JKsuper/Wrench-Racing/README.md

# Wrench Racing — AERO120 LC8

Open `AERO120_R413_ARCHITECTURE/START_HERE_换机接续.md` first, followed by its AGENTS.md and README.md.

Engineering baseline R4.13-LC8. Includes parameterized CadQuery sources, STEP/STL, assembly previews, BOM, geometric checks, manufacturing review and historical archives. Physical load, creep, sealing and aerodynamic validation remain outstanding.

Windows setup scripts are included. Cloud/Linux environments must install CadQuery 2.8.0 and the supplied requirements and verify font availability before rebuilding; Windows Arial Bold geometry must not be silently substituted.

Preserve exact file bytes: CLOUD_FILE_MANIFEST.json records SHA256 checksums. Build the current sources, not archived revisions.
