JKsuper/Wrench-Racing/AERO120_R413_ARCHITECTURE/START_HERE_换机接续.md

# AERO120 LC8 换机接续说明

当前基线 R4.13-LC8，2026-10-30。不要从旧 LC7 重建或混用旧 STL。
原工程目录 C:\Users\nanwa\Downloads\AERO120_R413\AERO120_R413_ARCHITECTURE。
对话属于“王越的项目”，当前任务 ID 01a187e0-4550-7770-b169-2c33f18580b5。
文件包不会自动迁移本地 Codex 对话；优先在同账号打开原对话。若原任务不可见，新对话读取本文件、AGENTS.md、README.md 即可恢复工程上下文。

## 新电脑操作
将整个目录复制/解压到本机可写位置，再在 Codex 中授权该文件夹。
Windows x64 推荐 Python 3.12（原环境3.12.14），CadQuery2.8.0，依赖见03_Codex/simple_lc2/requirements.txt。
先运行 setup_environment.ps1，再运行 run_local.ps1；也可由 Codex 按脚本逐项执行。
不要复用旧机器 AERO120_RUNTIME 环境变量；默认使用项目本地 .venv。不要在两台电脑同时修改同一工作副本。
Wrench Racing 使用 Windows Arial Bold，其他平台或字体不同可能改变字形，必须复核。
当前依赖安装流程尚未在第二台电脑实际运行；必须安装后执行完整构建、测试与导出核验，不承诺未经验证的环境零故障。

## 用户已确认的设计约束
- 单侧目标100元以内，不含风扇，尚无店铺报价。节省打印材料和构件数量，A主风道保持一体，不拆壳。
- 120×120×38–40mm风扇嵌入，腔体121.6mm/轴向43mm；105mm孔距仅参考。KF2510四针出线孔18×14/R2，软片封口。
- A一体风道、B双百叶、C打印底盖及四向支架、D带品牌的可换色前出口装饰盖，共4件。支架不夹在风扇/风道法兰之间。
- 用户现有非沉头M4×16与普通M4螺母；百叶及壳体连接按0.5mm薄平垫、3.5mm螺母包络计算。不是M3。
- 型材连接Ø7通孔配M4/M5/M6螺栓及对应T型槽螺母，用大平垫、每次选两孔；长度按实际T槽确定，不能默认全部16mm。
- 保留4040型材、左右镜像、四角加宽与耳根加强、STRIKE风口、品牌Wrench Racing不反写；D左右通用。
- LC7百叶正面装入曾干涉。LC8将中央造型脊及端桥移到可拆D，先装B再装D，不得恢复A上的固定中央桥。

## 已验证及待办
原目录30项几何回归通过，4份STL独立验证闭合/单连通且与STEP一致。右侧交店包位于12_Prototype_Review/PRINT_SHOP_RIGHT_LC8。
理论PETG净重约298g，不含支撑、损耗及切片变化。可选配合试片约6.5g，不是产品或强度试样。
尚未切片，A内部约110.4×64mm顶面需打印店确认支撑方向及清理方式。用户交打印店，未指定打印机。
后向线束弯曲、前向立柱避让、螺钉/垫圈实配、PETG承载/蠕变/振动/密封/气动需实物验证；几何通过不等于承载或性能通过。
下一步从当前LC8完整文件与交店要求继续，先检查最新校验清单，不重新设计一套。
