JKsuper/Wrench-Racing/AERO120_R413_ARCHITECTURE/12_Prototype_Review/00_打样结论.md

# 2026-10-30 打样审查结论

LC7不直接放行：正面装入百叶与固定中脊存在干涉，原记录00_LC7_assembly_issue_before_fix.json可复查。已修为LC8：中脊移到可拆D，主风道A仍一体；装入路径通过。

LC8四份实际STL经独立VTK读入，各单连通、无边界/非流形边，与对应有效单实体STEP的体积/尺寸相符。30项几何回归通过，型材Ø7通孔及M4/M5/M6示例轴/头/垫圈检查通过。不能把这些结果当作实物性能合格。

可把PRINT_SHOP_RIGHT_LC8发给店铺做首轮工程样评估，先回传A支撑切片和报价；A尚未签核实际切片，不应无条件整套开打。可选3个配合试片在独立目录，总理论净重约6.5g，仅作孔/夹持/角部配合。默认建议先右侧验证，非左右批量订单。

用户已确认螺钉为非沉头，但薄平垫、实际风扇/插头、T螺母、打印层向和材料工艺仍需核对。后向线束和前侧高立柱是实际安装条件。承载/蠕变/气密/气动/成本均未实测或报价达标。
