JKsuper/Wrench-Racing/AERO120_R413_ARCHITECTURE/12_Prototype_Review/OPTIONAL_FIT_COUPONS_NOT_PRODUCT/00_READ_FIRST.md

# 可选接口试片，不是产品零件

仅用于M4转轴孔/夹持和风扇角部配合，先与实物螺钉螺母及风扇试配。不要把这些试片混入四件产品的打印数量。不能用试片证明整机强度或整圈气密。各文件独立打印、自动落平台，不要按装配坐标合并。
