JKsuper/Wrench-Racing/AERO120_R413_ARCHITECTURE/01_Schematics/R413_模块化结构提案.png

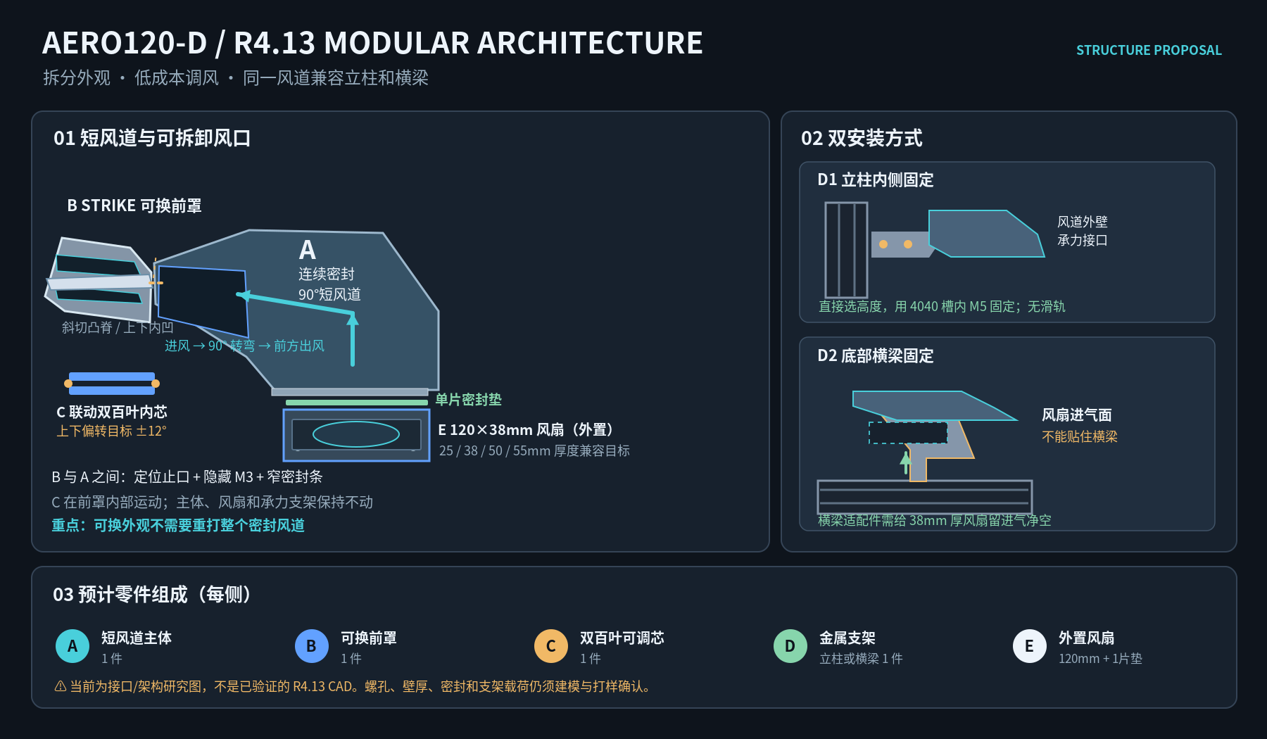
AERO120_R413_ARCHITECTURE/01_Schematics/R413_模块化结构提案.png
