JKsuper/Wrench-Racing/AERO120_R413_ARCHITECTURE/10_Previews/center_section_dimensions.png

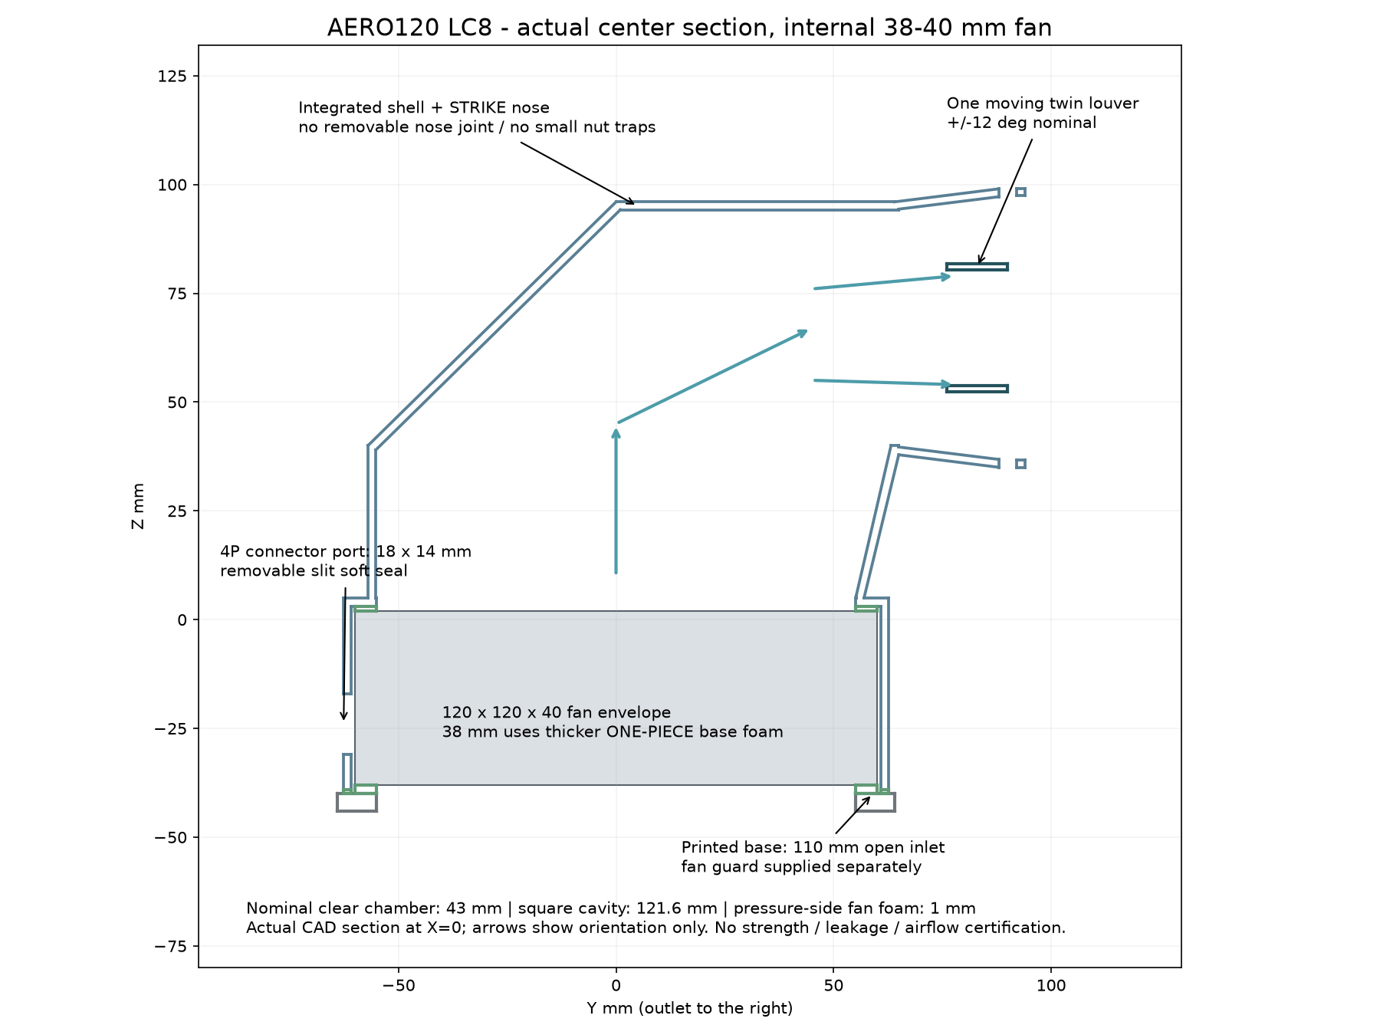
AERO120_R413_ARCHITECTURE/10_Previews/center_section_dimensions.png
