JKsuper/Wrench-Racing/AERO120_R413_ARCHITECTURE/10_Previews/corner_reinforcement_comparison.png

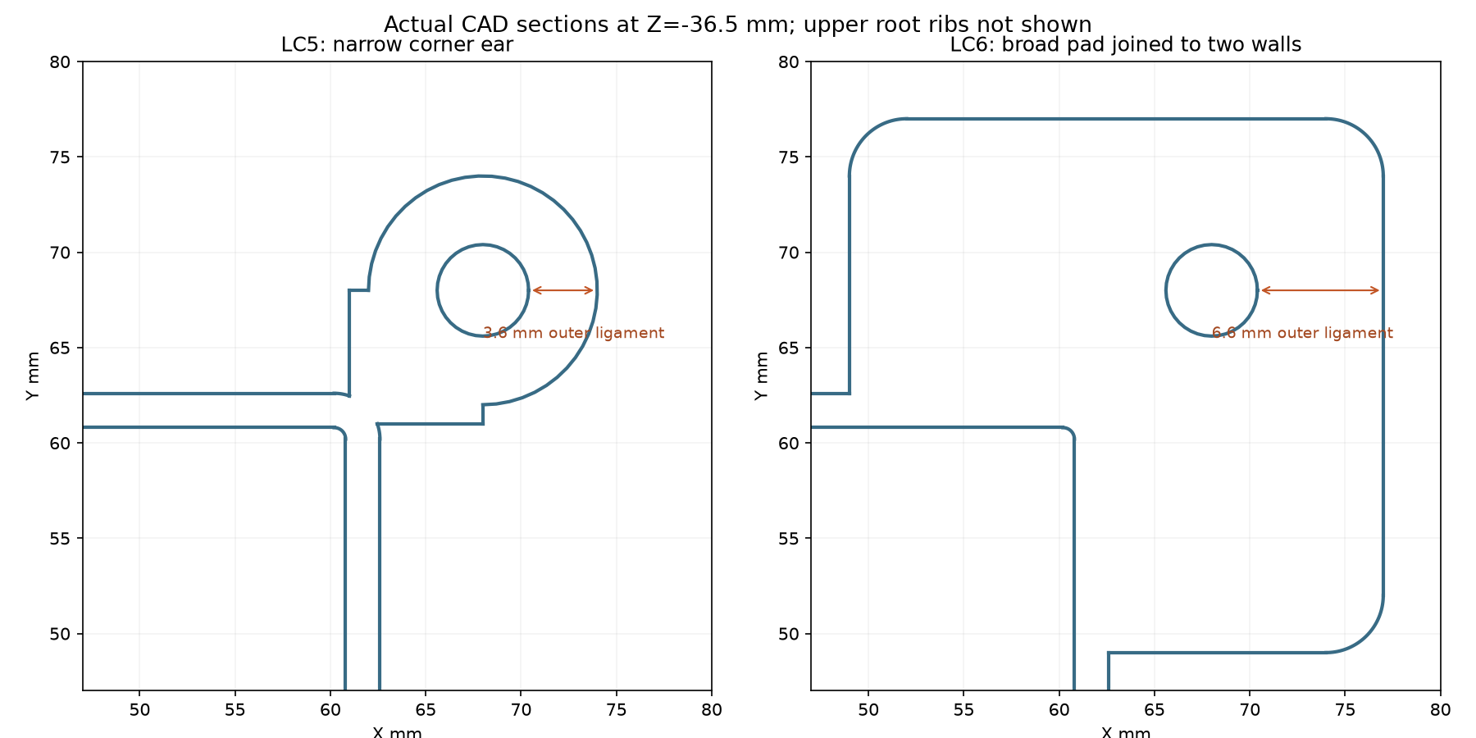
AERO120_R413_ARCHITECTURE/10_Previews/corner_reinforcement_comparison.png
