JKsuper/Wrench-Racing/AERO120_R413_ARCHITECTURE/10_Previews/exploded.png

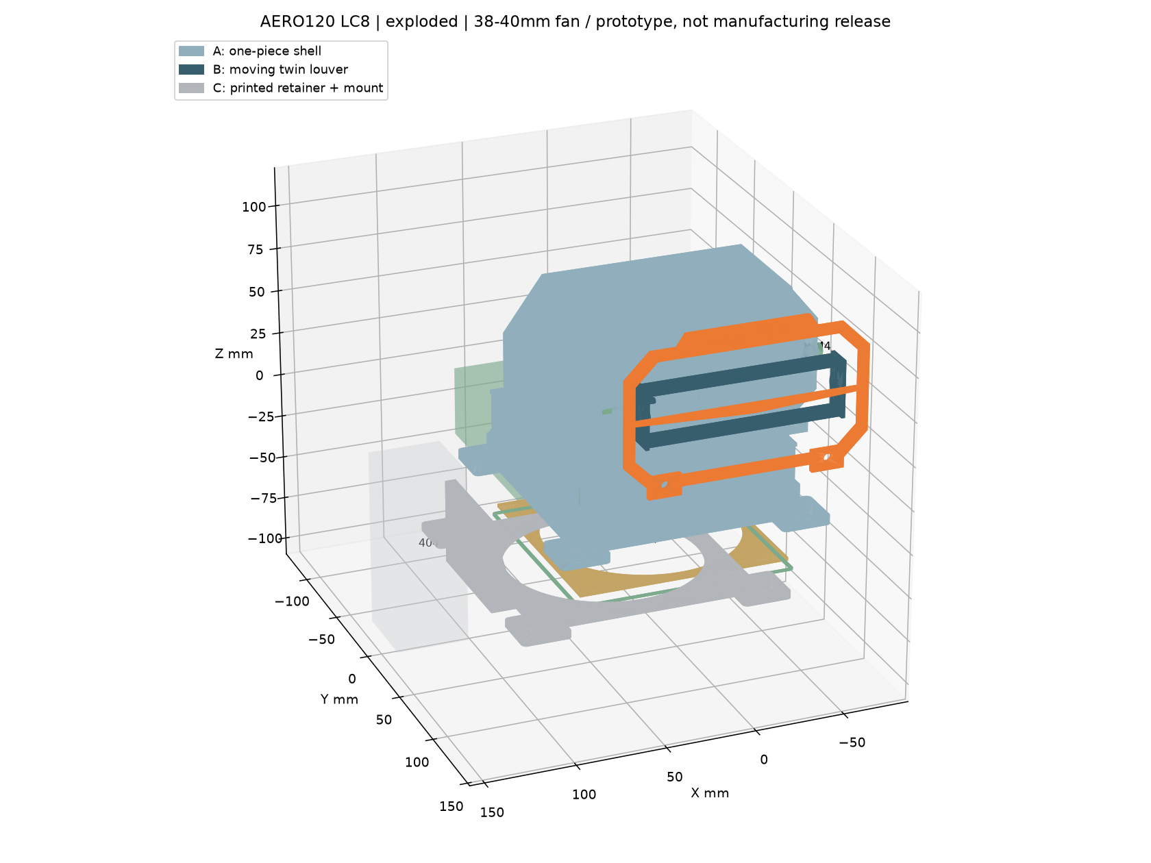
AERO120_R413_ARCHITECTURE/10_Previews/exploded.png
