JKsuper/Wrench-Racing/AERO120_R413_ARCHITECTURE/10_Previews/fan_housing_section.png

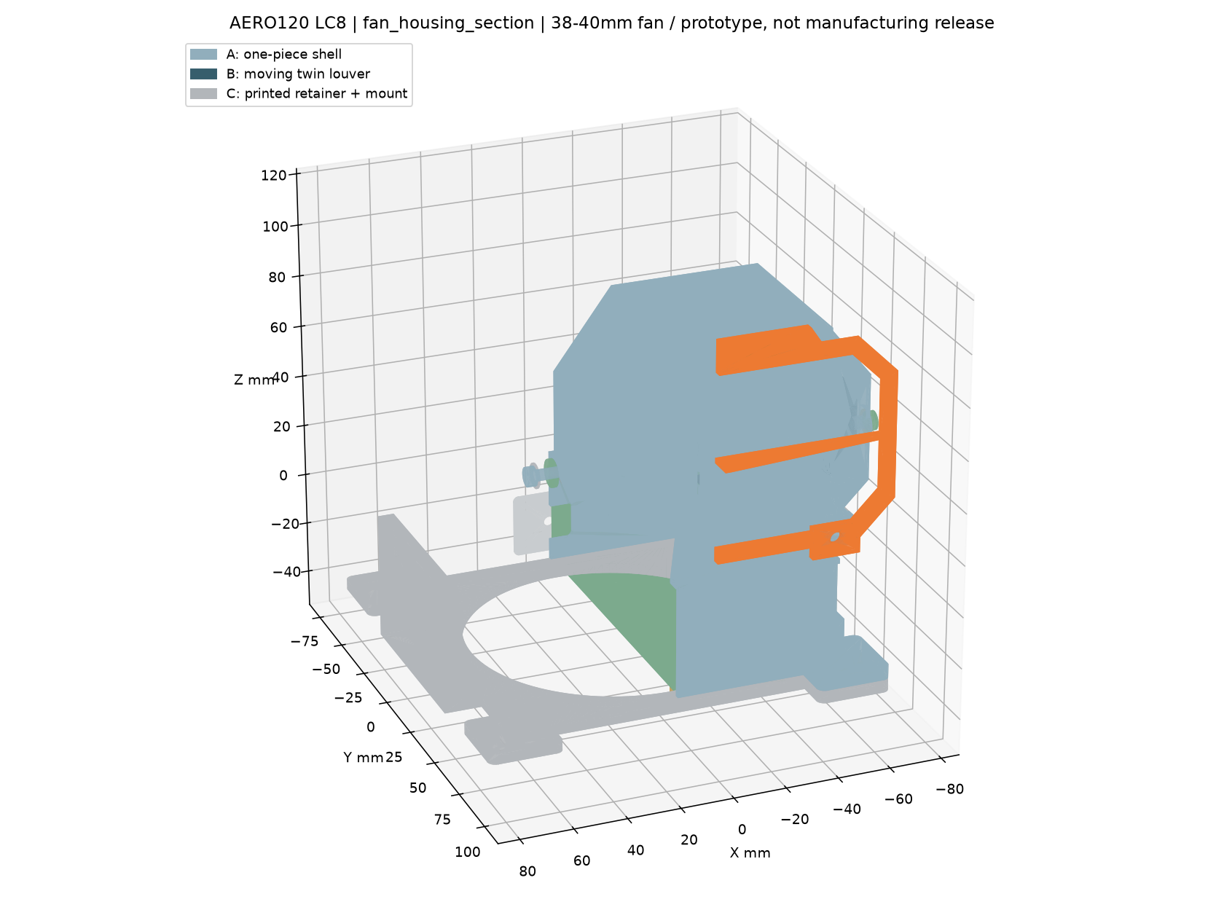
AERO120_R413_ARCHITECTURE/10_Previews/fan_housing_section.png
