JKsuper/Wrench-Racing/AERO120_R413_ARCHITECTURE/10_Previews/front_bezel_only.png

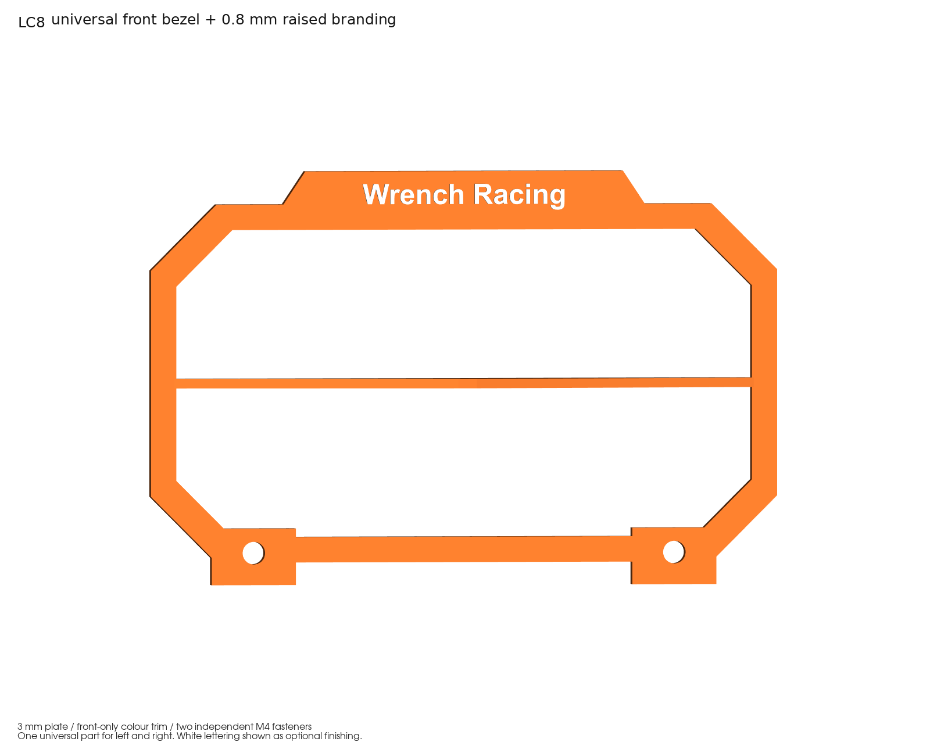
AERO120_R413_ARCHITECTURE/10_Previews/front_bezel_only.png
