JKsuper/Wrench-Racing/AERO120_R413_ARCHITECTURE/10_Previews/profile_mount_M4_M5_M6.png

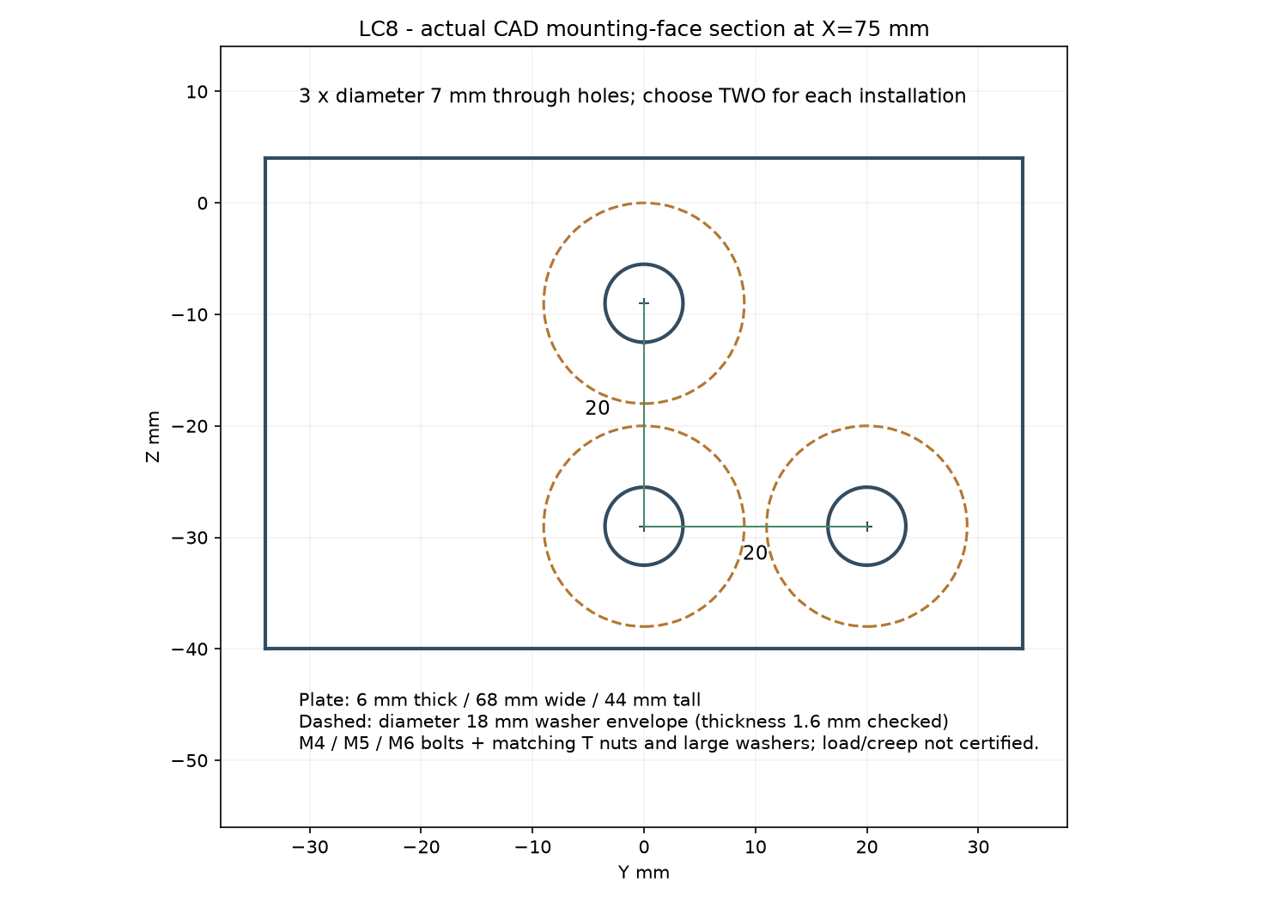
AERO120_R413_ARCHITECTURE/10_Previews/profile_mount_M4_M5_M6.png
