JKsuper/Wrench-Racing/AERO120_R413_ARCHITECTURE/10_Previews/STRIKE_outlet_detail.png

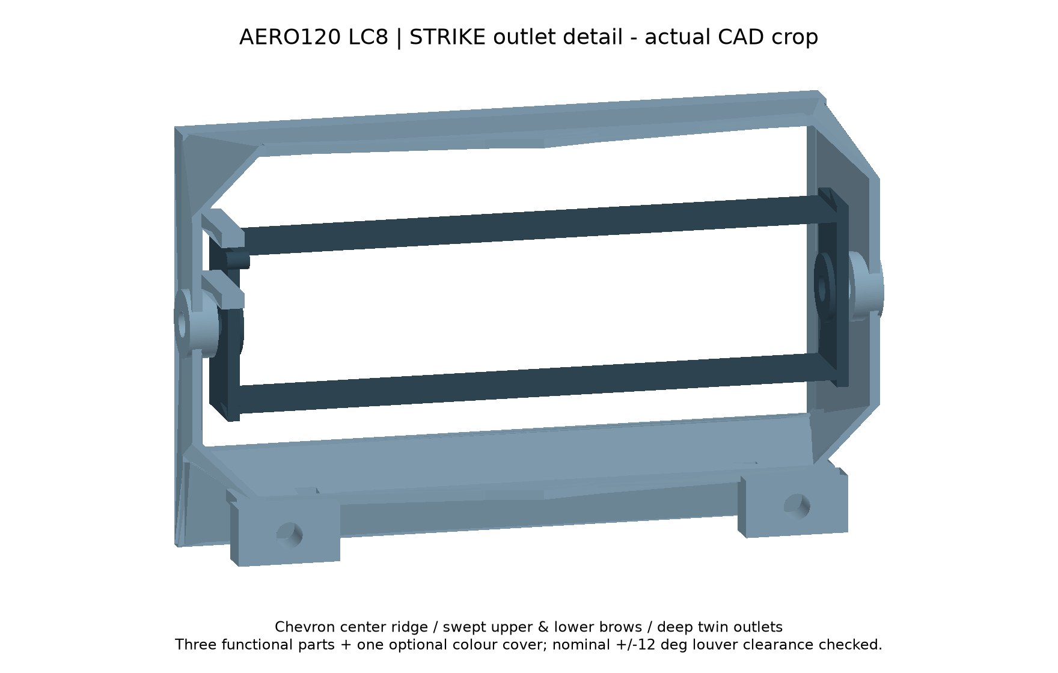
AERO120_R413_ARCHITECTURE/10_Previews/STRIKE_outlet_detail.png
