JKsuper/Wrench-Racing/AERO120_R413_ARCHITECTURE/10_Previews/Wrench_Racing_front_bezel.png

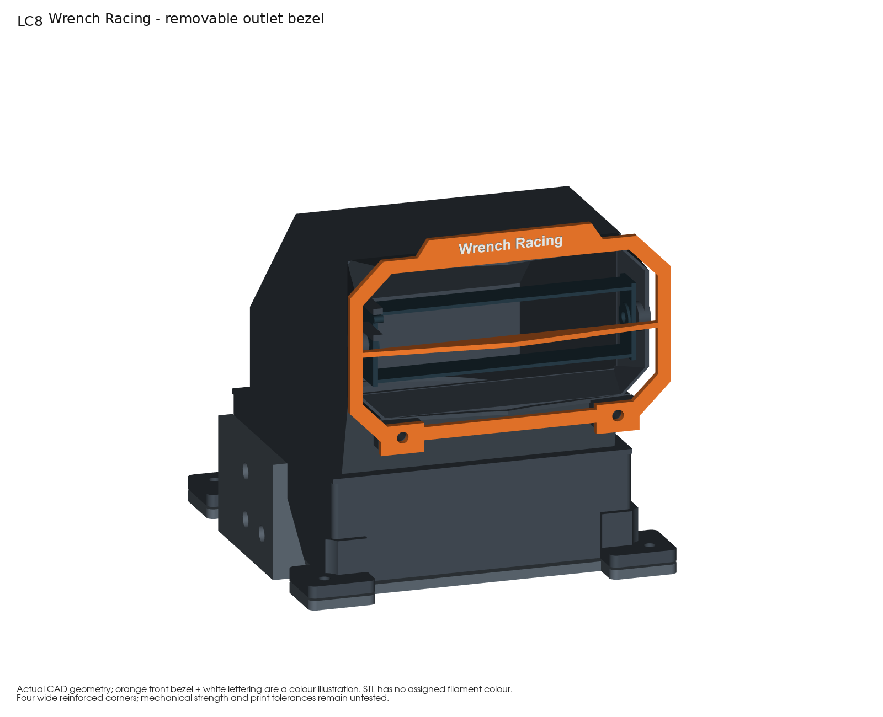
AERO120_R413_ARCHITECTURE/10_Previews/Wrench_Racing_front_bezel.png
