JKsuper/Wrench-Racing/AERO120_R413_ARCHITECTURE/12_Prototype_Review/PRINT_SHOP_RIGHT_LC8/06_尺寸与理论用料.csv

文件 | 数量 | 边界尺寸mm_原装配方向 | PETG净重g_1.27密度 | 备注
01_A_integrated_shell.stl | 1 | 154.00 x 179.00 x 138.00 | 204.32 | 不含支撑和填充/损耗差异
02_B_twin_louver.stl | 1 | 112.00 x 21.50 x 32.00 | 7.76 | 不含支撑和填充/损耗差异
03_C_printed_base_mount.stl | 1 | 155.00 x 154.00 x 48.00 | 73.50 | 不含支撑和填充/损耗差异
04_D_Wrench_Racing_front_bezel.stl | 1 | 134.00 x 9.00 x 87.80 | 12.45 | 不含支撑和填充/损耗差异
