JKsuper/Wrench-Racing/AERO120_R413_ARCHITECTURE/08_BOM/BOM_单侧.csv

编号 | 零件 | 数量 | 规格 | 制造方式 | 备注
A | 一体外壳 | 1 | 38至40mm风扇/121.6方腔 | 打印 | 带28x28宽承压角区及耳根筋
B | 活动双百叶 | 1 | 共轴±12度候选 | 打印 | 两侧M4普通五金固定
C | 底盖及加筋支架 | 1 | 4mm底板6mm侧壁3mm筋/四角加宽 | 打印 | 不再购买金属件或抱箍
H1 | 底盖固定螺栓 | 4 | M4x16候选 | 采购 | 长度需实装核对
H2 | 底盖螺母 | 4 | M4普通螺母或防松螺母 | 采购 | 外置可操作
H3 | 底盖平垫圈 | 8 | 内径4.4外径9厚0.5mm薄平垫 | 采购 | 底盖长度按薄垫核对/替换厚度需重算
H4 | 百叶轴螺钉螺母垫圈 | 2套 | M4x16普通螺母/每套两片0.5mm薄平垫及摩擦片 | 采购 | 保持角度与轴孔泄漏实测
H5 | 型材连接件 | 2套 | M4/M5/M6任选一规格与实际槽型T螺母及大平垫 | 采购 | Ø7通孔/不能裸头压孔/螺栓长度另核对
S1 | 顶部风扇密封圈 | 1 | 装配厚1mm候选 | 整圈泡棉 | 未压缩厚度依材料压缩曲线选择
S2 | 底部夹持泡棉 | 1 | 40mm扇装配2mm厚/38mm扇4mm厚 | 整圈泡棉 | 不得用多个小打印垫块代替
S3 | 底盖外圈密封 | 1 | 装配厚1mm候选 | 泡棉 | 检查四角与预压
S4 | 出线软密封片及止拉 | 1套 | 18x14孔外覆28x24割缝片 | 软材料采购 | 插头先穿后装风扇
X | 120mm风扇及护网 | 0 | 38至40mm厚用户自备 | 不计入报价 | 保留105孔矩参考
D | 带Wrench Racing及可拆中脊的前饰盖 | 1可选 | 3mm平面前框/前方独立拆装 | 打印 | 先装B后装D/中脊不再固定在A
H6 | 外罩螺栓螺母平垫圈 | 2套可选 | M4x16加普通M4螺母及两片0.5mm平垫 | 采购 | 前下方沿Y固定/不借用百叶螺钉
