JKsuper/Wrench-Racing/AERO120_R413_ARCHITECTURE/05_STEP/R_A_integrated_shell.step

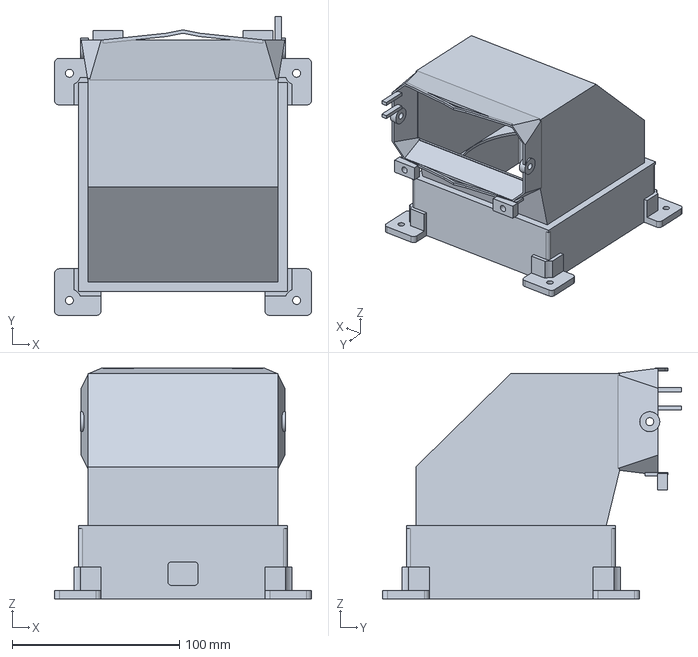
[picture p10: CAD file, 2026-10-29]
AERO120_R413_ARCHITECTURE/05_STEP/R_A_integrated_shell.step
154.0 x 179.0 x 138.0 mm
