JKsuper/Wrench-Racing/AERO120_R413_ARCHITECTURE/06_STL/04_D_Wrench_Racing_front_bezel.stl

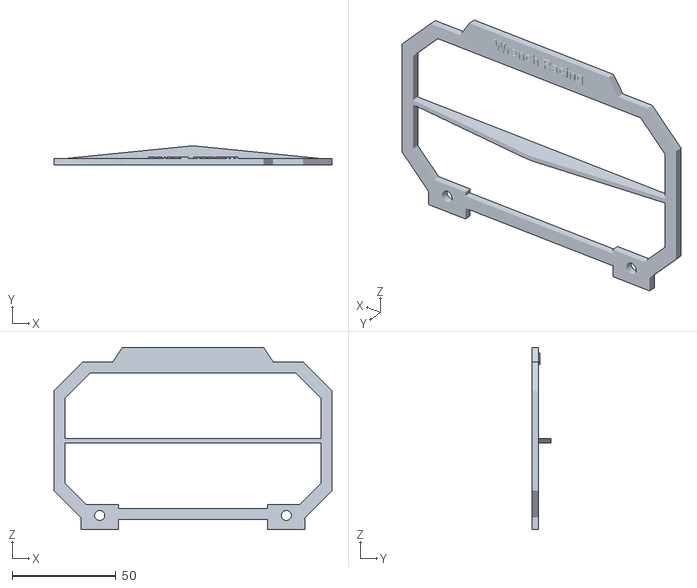
[picture p11: CAD file, 2026-10-29]
AERO120_R413_ARCHITECTURE/06_STL/04_D_Wrench_Racing_front_bezel.stl
134.0 x 9.00 x 87.8
