JKsuper/Wrench-Racing/AERO120_R413_ARCHITECTURE/11_Manufacturing/LC6_corner_reference.step

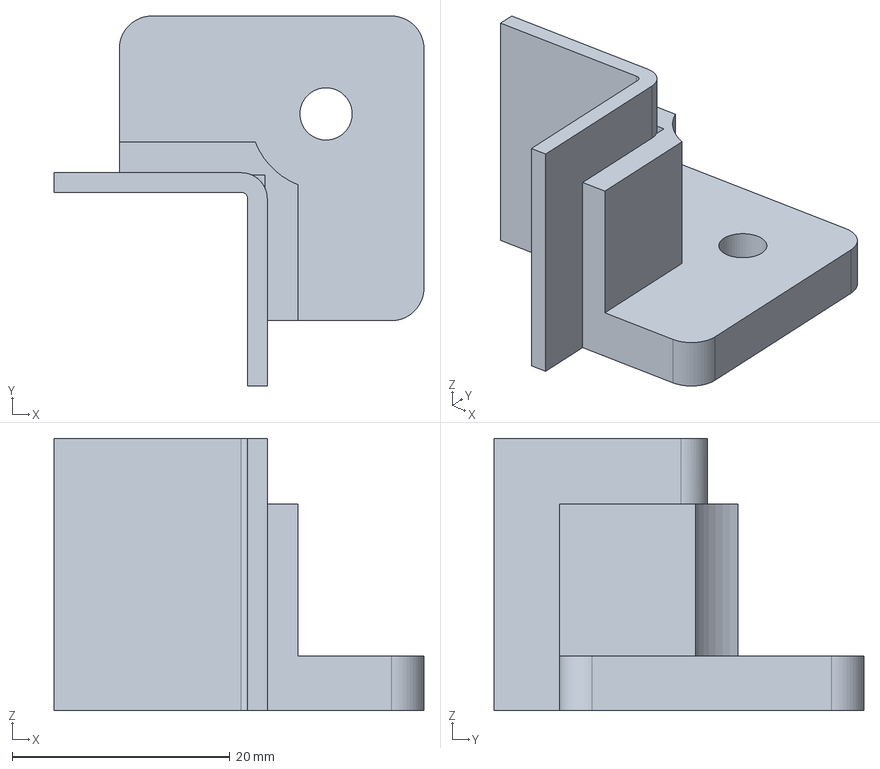
[picture p13: CAD file, 2026-10-29]
AERO120_R413_ARCHITECTURE/11_Manufacturing/LC6_corner_reference.step
34.0 x 34.0 x 25.0 mm
