JKsuper/Wrench-Racing/AERO120_R413_ARCHITECTURE/12_Prototype_Review/OPTIONAL_FIT_COUPONS_NOT_PRODUCT/COUPON_fan_corner_1.step

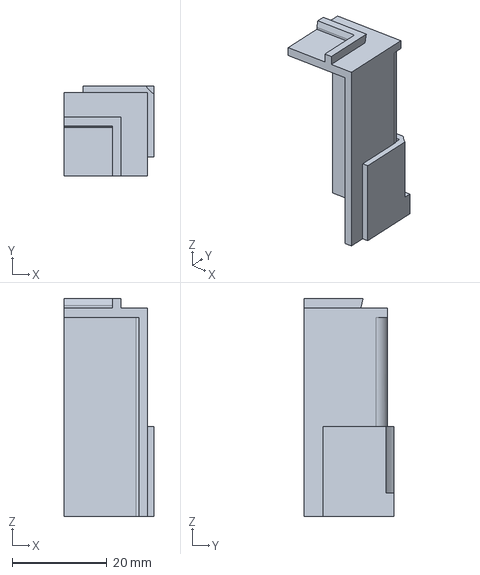
[picture p14: CAD file, 2026-10-29]
AERO120_R413_ARCHITECTURE/12_Prototype_Review/OPTIONAL_FIT_COUPONS_NOT_PRODUCT/COUPON_fan_corner_1.step
19.0 x 19.0 x 46.0 mm
