JKsuper/Wrench-Racing/AERO120_R413_ARCHITECTURE/06_STL/02_B_twin_louver.stl

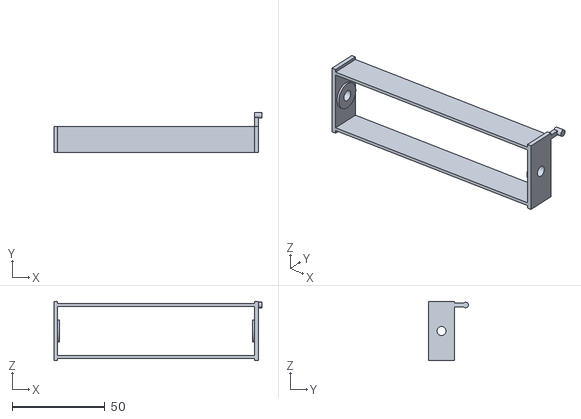
[picture p15: CAD file, 2026-10-29]
AERO120_R413_ARCHITECTURE/06_STL/02_B_twin_louver.stl
112.0 x 21.5 x 32.0
