JKsuper/Wrench-Racing/AERO120_R413_ARCHITECTURE/11_Manufacturing/LC5_corner_reference.step

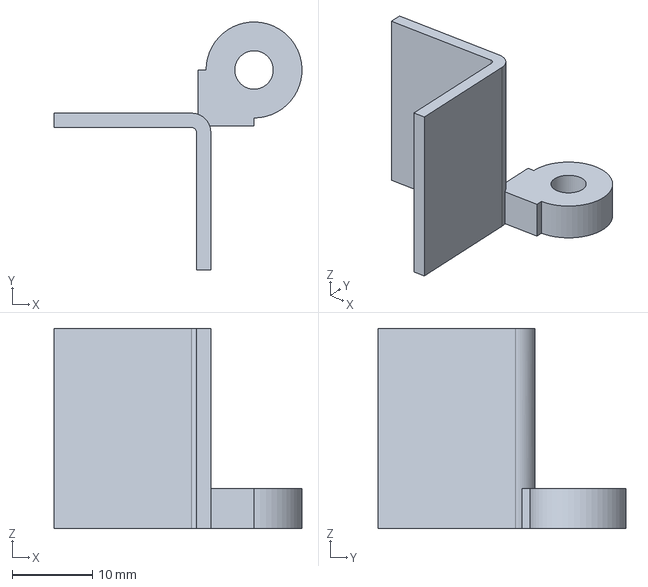
[picture p16: CAD file, 2026-10-29]
AERO120_R413_ARCHITECTURE/11_Manufacturing/LC5_corner_reference.step
31.0 x 31.0 x 25.0 mm
