JKsuper/Wrench-Racing/AERO120_R413_ARCHITECTURE/12_Prototype_Review/OPTIONAL_FIT_COUPONS_NOT_PRODUCT/COUPON_B_axis_1.step

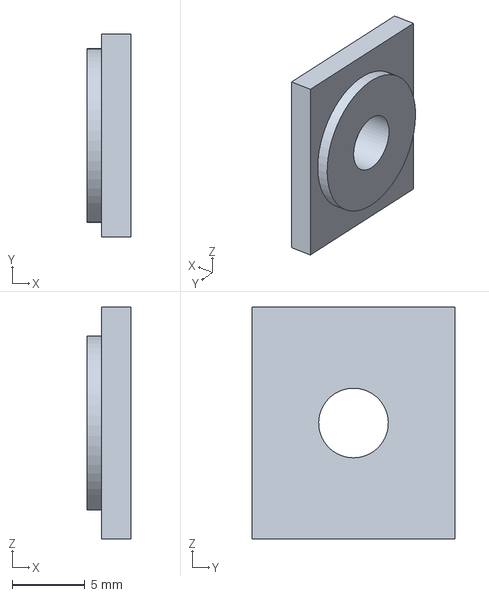
[picture p17: CAD file, 2026-10-29]
AERO120_R413_ARCHITECTURE/12_Prototype_Review/OPTIONAL_FIT_COUPONS_NOT_PRODUCT/COUPON_B_axis_1.step
3.00 x 14.0 x 16.0 mm
