JKsuper/Wrench-Racing/AERO120_R413_ARCHITECTURE/06_STL/03_C_printed_base_mount.stl

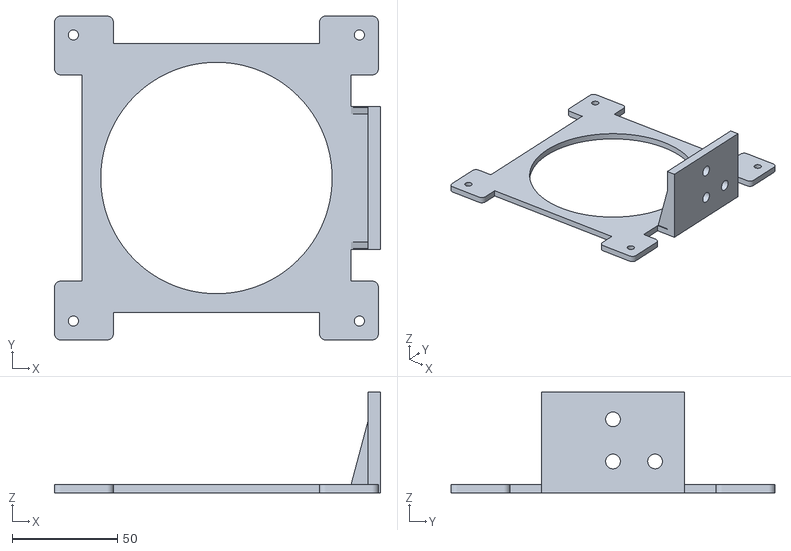
[picture p18: CAD file, 2026-10-29]
AERO120_R413_ARCHITECTURE/06_STL/03_C_printed_base_mount.stl
155.0 x 154.0 x 48.0
