JKsuper/Wrench-Racing/AERO120_R413_ARCHITECTURE/07_Assembly/R_fourway_270_upright.step

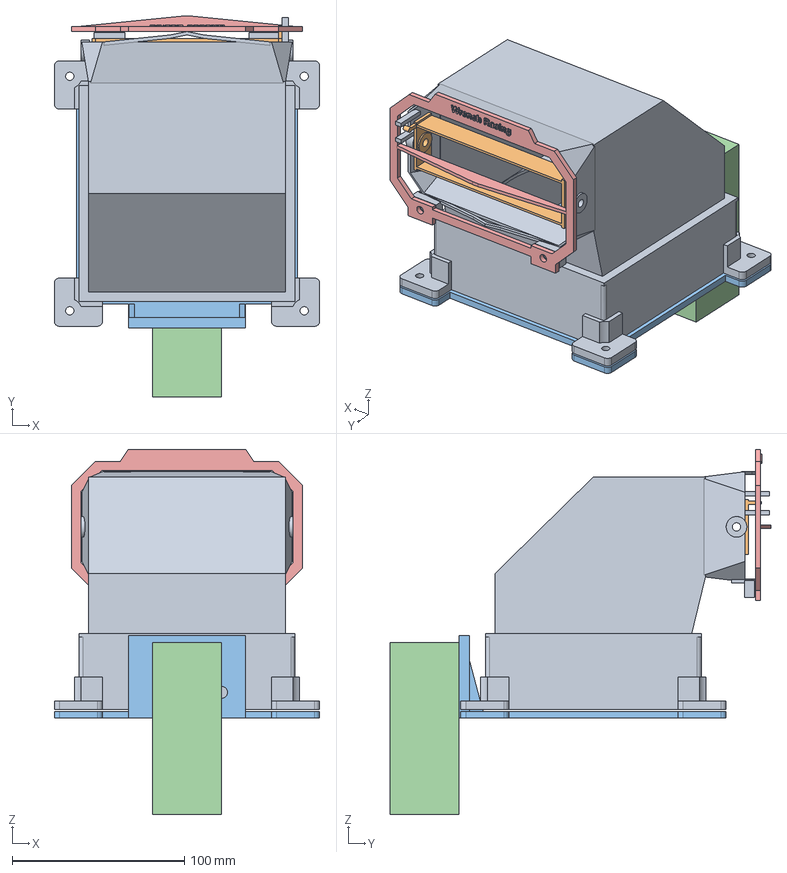
[picture p19: CAD file, 2026-10-29]
AERO120_R413_ARCHITECTURE/07_Assembly/R_fourway_270_upright.step
154.0 x 221.0 x 212.0 mm
A
B
C
4040_obstruction
D_cover
