JKsuper/Wrench-Racing/AERO120_R413_ARCHITECTURE/07_Assembly/L_upright.step

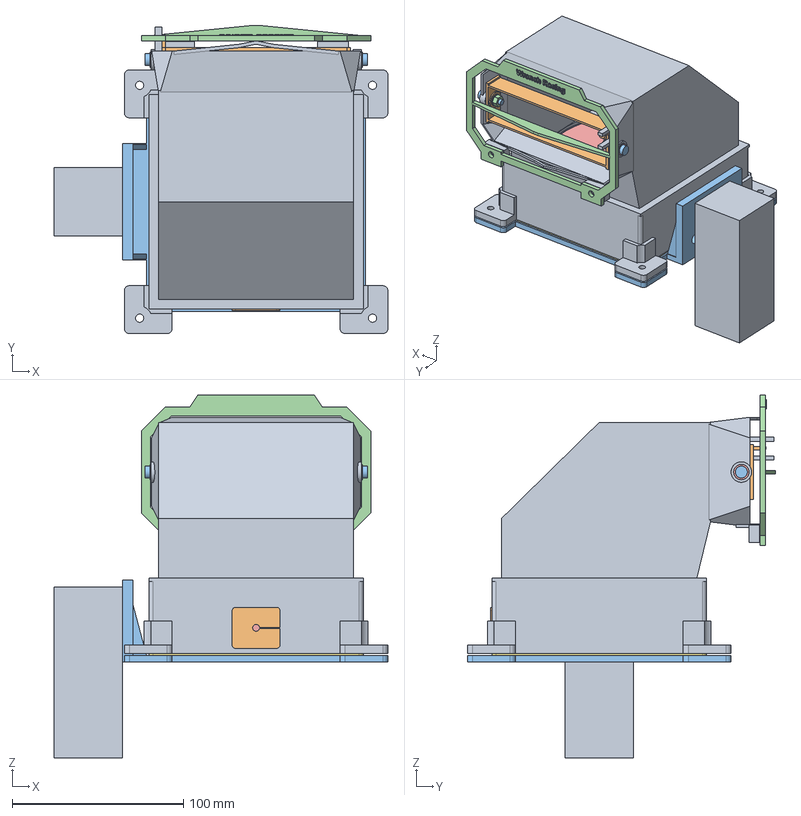
[picture p21: CAD file, 2026-10-29]
AERO120_R413_ARCHITECTURE/07_Assembly/L_upright.step
195.0 x 180.0 x 212.0 mm
A_integrated_shell
B_twin_louver
C_printed_base_mount
D_Wrench_Racing_front_bezel
fan_ENVELOPE
fan_face_foam_REFERENCE
cap_seal_REFERENCE
base_foam_REFERENCE
4040_OBSTRUCTION
slit_seal_PATCH_NOT_PRINT
M4_R_screw_REFERENCE
M4_R_nut_REFERENCE
M4_R_outer_washer_REFERENCE
M4_R_inner_washer_REFERENCE
M4_R_friction_washer_REFERENCE
M4_L_screw_REFERENCE
M4_L_nut_REFERENCE
M4_L_outer_washer_REFERENCE
M4_L_inner_washer_REFERENCE
M4_L_friction_washer_REFERENCE
