JKsuper/Wrench-Racing/AERO120_R413_ARCHITECTURE/07_Assembly/R_fourway_270_crossbar.step

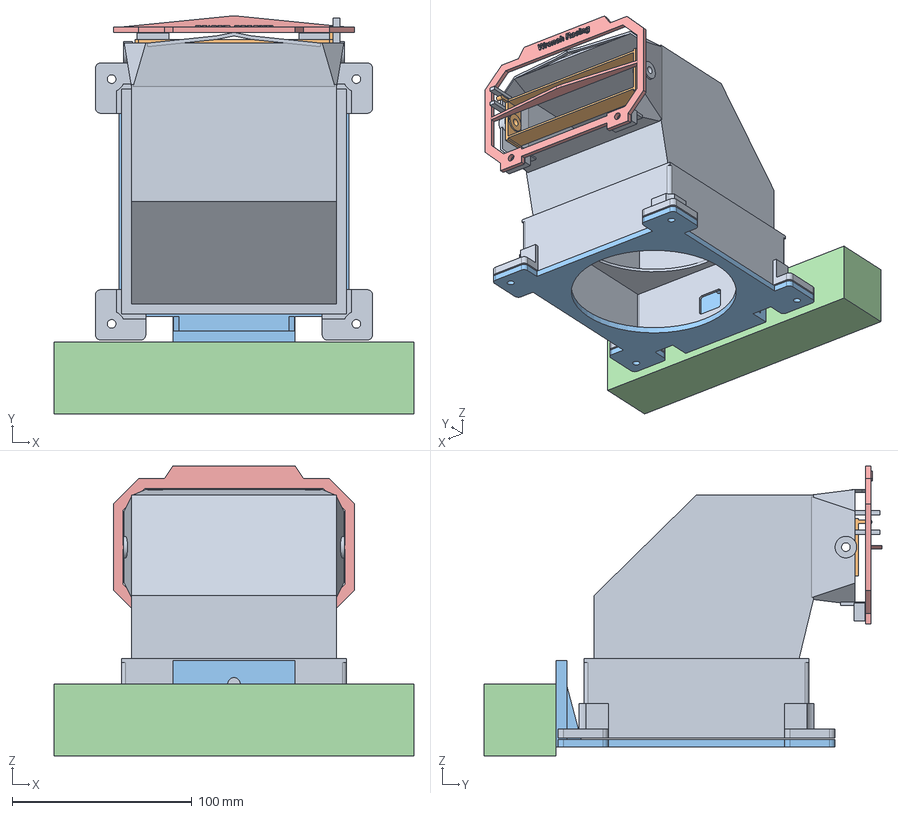
[picture p24: CAD file, 2026-10-29]
AERO120_R413_ARCHITECTURE/07_Assembly/R_fourway_270_crossbar.step
200.0 x 221.0 x 161.0 mm
A
B
C
4040_obstruction
D_cover
