JKsuper/Wrench-Racing/(list of files, cad)

Other CAD files:
AERO120_R413_ARCHITECTURE/12_Prototype_Review/PRINT_SHOP_RIGHT_LC8/01_A_integrated_shell.stl
AERO120_R413_ARCHITECTURE/05_STEP/L_A_integrated_shell.step
AERO120_R413_ARCHITECTURE/07_Assembly/L_crossbar.step
AERO120_R413_ARCHITECTURE/05_STEP/R_B_twin_louver.step
AERO120_R413_ARCHITECTURE/05_STEP/R_D_Wrench_Racing_front_bezel.step
AERO120_R413_ARCHITECTURE/06_STL/01_A_integrated_shell.stl
AERO120_R413_ARCHITECTURE/05_STEP/R_C_printed_base_mount.step
AERO120_R413_ARCHITECTURE/05_STEP/L_D_Wrench_Racing_front_bezel.step
AERO120_R413_ARCHITECTURE/07_Assembly/R_upright.step
AERO120_R413_ARCHITECTURE/05_STEP/L_C_printed_base_mount.step
AERO120_R413_ARCHITECTURE/05_STEP/L_B_twin_louver.step
AERO120_R413_ARCHITECTURE/07_Assembly/R_fourway_180_crossbar.step
AERO120_R413_ARCHITECTURE/07_Assembly/R_fourway_180_upright.step
AERO120_R413_ARCHITECTURE/07_Assembly/R_fourway_90_crossbar.step
AERO120_R413_ARCHITECTURE/00_Archive/LC1_before_LC2_20261029_231237/05_STEP/L_A_duct.step
AERO120_R413_ARCHITECTURE/00_Archive/LC1_before_LC2_20261029_231237/05_STEP/L_B_STRIKE_mask.step
AERO120_R413_ARCHITECTURE/00_Archive/LC1_before_LC2_20261029_231237/05_STEP/L_C_twin_louver.step
AERO120_R413_ARCHITECTURE/00_Archive/LC1_before_LC2_20261029_231237/05_STEP/L_D_common_bracket.step
AERO120_R413_ARCHITECTURE/00_Archive/LC1_before_LC2_20261029_231237/05_STEP/L_E_fan_gasket_installed.step
AERO120_R413_ARCHITECTURE/00_Archive/LC1_before_LC2_20261029_231237/05_STEP/L_F_mask_gasket_installed.step
AERO120_R413_ARCHITECTURE/00_Archive/LC1_before_LC2_20261029_231237/05_STEP/L_washer_-15_30.step
AERO120_R413_ARCHITECTURE/00_Archive/LC1_before_LC2_20261029_231237/05_STEP/L_washer_-15_50.step
AERO120_R413_ARCHITECTURE/00_Archive/LC1_before_LC2_20261029_231237/05_STEP/L_washer_15_30.step
AERO120_R413_ARCHITECTURE/00_Archive/LC1_before_LC2_20261029_231237/05_STEP/L_washer_15_50.step
AERO120_R413_ARCHITECTURE/00_Archive/LC1_before_LC2_20261029_231237/05_STEP/R_A_duct.step
AERO120_R413_ARCHITECTURE/00_Archive/LC1_before_LC2_20261029_231237/05_STEP/R_B_STRIKE_mask.step
AERO120_R413_ARCHITECTURE/00_Archive/LC1_before_LC2_20261029_231237/05_STEP/R_C_twin_louver.step
AERO120_R413_ARCHITECTURE/00_Archive/LC1_before_LC2_20261029_231237/05_STEP/R_D_common_bracket.step
AERO120_R413_ARCHITECTURE/00_Archive/LC1_before_LC2_20261029_231237/05_STEP/R_E_fan_gasket_installed.step
AERO120_R413_ARCHITECTURE/00_Archive/LC1_before_LC2_20261029_231237/05_STEP/R_F_mask_gasket_installed.step
AERO120_R413_ARCHITECTURE/00_Archive/LC1_before_LC2_20261029_231237/05_STEP/R_washer_-15_30.step
AERO120_R413_ARCHITECTURE/00_Archive/LC1_before_LC2_20261029_231237/05_STEP/R_washer_-15_50.step
AERO120_R413_ARCHITECTURE/00_Archive/LC1_before_LC2_20261029_231237/05_STEP/R_washer_15_30.step
AERO120_R413_ARCHITECTURE/00_Archive/LC1_before_LC2_20261029_231237/05_STEP/R_washer_15_50.step
AERO120_R413_ARCHITECTURE/00_Archive/LC1_before_LC2_20261029_231237/06_STL/L_A_duct.stl
AERO120_R413_ARCHITECTURE/00_Archive/LC1_before_LC2_20261029_231237/06_STL/L_B_STRIKE_mask.stl
AERO120_R413_ARCHITECTURE/00_Archive/LC1_before_LC2_20261029_231237/06_STL/L_C_twin_louver.stl
AERO120_R413_ARCHITECTURE/00_Archive/LC1_before_LC2_20261029_231237/06_STL/L_D_common_bracket.stl
AERO120_R413_ARCHITECTURE/00_Archive/LC1_before_LC2_20261029_231237/06_STL/L_E_fan_gasket_installed.stl
AERO120_R413_ARCHITECTURE/00_Archive/LC1_before_LC2_20261029_231237/06_STL/L_F_mask_gasket_installed.stl
AERO120_R413_ARCHITECTURE/00_Archive/LC1_before_LC2_20261029_231237/06_STL/L_washer_-15_30.stl
AERO120_R413_ARCHITECTURE/00_Archive/LC1_before_LC2_20261029_231237/06_STL/L_washer_-15_50.stl
AERO120_R413_ARCHITECTURE/00_Archive/LC1_before_LC2_20261029_231237/06_STL/L_washer_15_30.stl
AERO120_R413_ARCHITECTURE/00_Archive/LC1_before_LC2_20261029_231237/06_STL/L_washer_15_50.stl
AERO120_R413_ARCHITECTURE/00_Archive/LC1_before_LC2_20261029_231237/06_STL/R_A_duct.stl
AERO120_R413_ARCHITECTURE/00_Archive/LC1_before_LC2_20261029_231237/06_STL/R_B_STRIKE_mask.stl
AERO120_R413_ARCHITECTURE/00_Archive/LC1_before_LC2_20261029_231237/06_STL/R_C_twin_louver.stl
AERO120_R413_ARCHITECTURE/00_Archive/LC1_before_LC2_20261029_231237/06_STL/R_D_common_bracket.stl
AERO120_R413_ARCHITECTURE/00_Archive/LC1_before_LC2_20261029_231237/06_STL/R_E_fan_gasket_installed.stl
AERO120_R413_ARCHITECTURE/00_Archive/LC1_before_LC2_20261029_231237/06_STL/R_F_mask_gasket_installed.stl
AERO120_R413_ARCHITECTURE/00_Archive/LC1_before_LC2_20261029_231237/06_STL/R_washer_-15_30.stl
AERO120_R413_ARCHITECTURE/00_Archive/LC1_before_LC2_20261029_231237/06_STL/R_washer_-15_50.stl
AERO120_R413_ARCHITECTURE/00_Archive/LC1_before_LC2_20261029_231237/06_STL/R_washer_15_30.stl
AERO120_R413_ARCHITECTURE/00_Archive/LC1_before_LC2_20261029_231237/06_STL/R_washer_15_50.stl
AERO120_R413_ARCHITECTURE/00_Archive/LC1_before_LC2_20261029_231237/07_Assembly/L_crossbar_assembly.step
AERO120_R413_ARCHITECTURE/00_Archive/LC1_before_LC2_20261029_231237/07_Assembly/L_crossbar_exploded.step
AERO120_R413_ARCHITECTURE/00_Archive/LC1_before_LC2_20261029_231237/07_Assembly/L_upright_assembly.step
AERO120_R413_ARCHITECTURE/00_Archive/LC1_before_LC2_20261029_231237/07_Assembly/L_upright_exploded.step
AERO120_R413_ARCHITECTURE/00_Archive/LC1_before_LC2_20261029_231237/07_Assembly/R_crossbar_assembly.step
AERO120_R413_ARCHITECTURE/00_Archive/LC1_before_LC2_20261029_231237/07_Assembly/R_crossbar_exploded.step
AERO120_R413_ARCHITECTURE/00_Archive/LC1_before_LC2_20261029_231237/07_Assembly/R_upright_assembly.step
AERO120_R413_ARCHITECTURE/00_Archive/LC1_before_LC2_20261029_231237/07_Assembly/R_upright_exploded.step
AERO120_R413_ARCHITECTURE/00_Archive/LC1_before_LC2_20261029_231237/11_Manufacturing/D_common_bracket_FLAT_K04_UNQUALIFIED.dxf
AERO120_R413_ARCHITECTURE/00_Archive/LC1_before_LC2_20261029_231237/11_Manufacturing/coupons/A_duct_fit_coupon_1.step
AERO120_R413_ARCHITECTURE/00_Archive/LC1_before_LC2_20261029_231237/11_Manufacturing/coupons/A_duct_fit_coupon_1.stl
AERO120_R413_ARCHITECTURE/00_Archive/LC1_before_LC2_20261029_231237/11_Manufacturing/coupons/B_STRIKE_mask_fit_coupon_1.step
AERO120_R413_ARCHITECTURE/00_Archive/LC1_before_LC2_20261029_231237/11_Manufacturing/coupons/B_STRIKE_mask_fit_coupon_1.stl
AERO120_R413_ARCHITECTURE/00_Archive/LC1_before_LC2_20261029_231237/11_Manufacturing/coupons/C_twin_louver_fit_coupon_1.step
AERO120_R413_ARCHITECTURE/00_Archive/LC1_before_LC2_20261029_231237/11_Manufacturing/coupons/C_twin_louver_fit_coupon_1.stl
AERO120_R413_ARCHITECTURE/00_Archive/LC2_before_LC3_20261029_234240/05_STEP/L_A_integrated_shell.step
AERO120_R413_ARCHITECTURE/00_Archive/LC2_before_LC3_20261029_234240/05_STEP/L_B_twin_louver.step
AERO120_R413_ARCHITECTURE/00_Archive/LC2_before_LC3_20261029_234240/05_STEP/L_C_metal_cap_mount_NOT_PRINT.step
AERO120_R413_ARCHITECTURE/00_Archive/LC2_before_LC3_20261029_234240/05_STEP/R_A_integrated_shell.step
AERO120_R413_ARCHITECTURE/00_Archive/LC2_before_LC3_20261029_234240/05_STEP/R_B_twin_louver.step
AERO120_R413_ARCHITECTURE/00_Archive/LC2_before_LC3_20261029_234240/05_STEP/R_C_metal_cap_mount_NOT_PRINT.step
AERO120_R413_ARCHITECTURE/00_Archive/LC2_file_backup_20261029_234334/06_STL/01_A_integrated_shell.stl
AERO120_R413_ARCHITECTURE/00_Archive/LC2_file_backup_20261029_234334/06_STL/02_B_twin_louver.stl
AERO120_R413_ARCHITECTURE/00_Archive/LC2_file_backup_20261029_234334/07_Assembly/L_crossbar.step
AERO120_R413_ARCHITECTURE/00_Archive/LC2_file_backup_20261029_234334/07_Assembly/L_upright.step
AERO120_R413_ARCHITECTURE/00_Archive/LC2_file_backup_20261029_234334/07_Assembly/R_crossbar.step
AERO120_R413_ARCHITECTURE/00_Archive/LC2_file_backup_20261029_234334/07_Assembly/R_exploded.step
AERO120_R413_ARCHITECTURE/00_Archive/LC2_file_backup_20261029_234334/07_Assembly/R_upright.step
AERO120_R413_ARCHITECTURE/00_Archive/LC2_file_backup_20261029_234334/11_Manufacturing/C_metal_cap_mount_FLAT_UNQUALIFIED.dxf
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
