JKsuper/Wrench-Racing/AERO120_R413_ARCHITECTURE/11_Manufacturing/LC8_打样工艺要求.md

# 打印店确认单：LC8右侧首轮工程验证样

## 先评估后开打

本目录4个STL是A/B/C/D独立物理件，单位mm，每件暂按1件询价。所有STL保留装配坐标，请分别作为独立对象导入并落到平台/摆盘，不能合并成装配一体打印。请按05_FILE_MANIFEST.json核对文件，不用旧版/装配STEP/风扇型材占位模型。

材质普通PETG、工艺FDM，记录牌号批次。颜色先按每件单色报价；D可另色。白字不是STL颜色信息，先不强制多色清洗塔。材质替换需用户确认。

请回传以下内容后再打印大件A：

1. 每件方向、平台余量、层高、线宽/壁线、填充和局部实心设置。
2. A内部支撑预览及从Ø110入口/前出口可清理的方案，不能在内部留下无法取出的支撑。当前Z朝上约110×64mm内顶面应重点审核。
3. B的1.4mm叶片、D的2mm中脊和品牌笔画切片连续性；轴孔不能被自动补死。
4. C支架和A耳根的层向、螺母/垫圈承压区处理，以及去支撑后的密封面/孔尺寸。
5. 每件耗材克数、支撑克数、时长、加工/清理费和整套到手报价。预算目标100元不含用户自备风扇，尚未确认达标。

## 装配顺序与五金

先把C固定到实际4040的T螺母，再装A/风扇和底盖四角螺栓；先穿KF2510四针插头，再放风扇。B从前方装入、装两侧M4转轴及摩擦片，最后装带中脊的D前盖。不要在D中脊已挡住入口时强行装百叶。

百叶/底盖/前盖：非沉头M4×16，普通六角螺母（本轮包络厚3.5mm）及每面0.5mm薄平垫。实际头径/头高、螺母与平垫厚度要复核；不能把普通0.8/1mm平垫直接当0.5mm。前盖后侧螺钉头需实际工具试拧，包络检查不等于所有工具均可操作。

型材：Ø7通孔，M4/M5/M6任选一种，每次用2套匹配实际T槽的T螺母/螺栓/大平垫，螺栓长度另行核对。M4尤其要用大平垫防止头部陷孔。已检查最大外径18mm、厚1.6mm垫圈示例，打印件不按金属件标准扭矩拧紧。

四向安装需确认：前侧型材不要挡风口；后向安装时出线口、螺钉头和线束弯曲空间需要实装，不可压线。护网由用户自备。

## 验收范围

这是试装与性能验证样，不是已认证承力成品。先核对风扇间隙、孔位/轴孔、0/±12度调节与保持、装拆和支撑清理，再测试承载/蠕变/振动/温升、漏风与气流噪声。不要仅凭网格闭合或几何无碰撞签承载合格。
