JKsuper/Wrench-Racing/AERO120_R413_ARCHITECTURE/00_Archive/LC1_before_LC2_20261029_231237/11_Manufacturing/制造与风险.md

# 低成本制造路线与风险

## 成本设计选择

仅3个塑料主件A/B/C、1个金属支架D。D共用于两种安装方向，避免两款金属件的起步费。塑料壁厚1.8mm、百叶1.4mm均为候选，必须以实际工艺确认；不得为追求体积指标继续盲目减薄承力座。原124mm/5mm法兰保留，避免未经验证地削弱风扇接口。

优先询价FDM薄壁工艺和同几何的粉末类打印，比较包含支撑去除和表面质量的总价；不保证任一工艺首套能进入100元。树脂仅在材料韧性和嵌件试片通过后采用，不能按最低树脂报价决定承力材料。

## 打印方向候选

A出口法兰朝打印平台，沿-Y生长，是待切片方案。入口圆孔顶部、封闭后壁、加强座和螺母捕获槽可能仍需桥接或局部支撑。不要把折面外观当作无需支撑的证明。内部支撑应能从Ø110入口或110×54出口取出；切片软件应逐层核对，保留实际支撑重量、时长、接缝和层向报告。当前未运行切片软件。

B按出口面或后端套口向下进行两种方向切片比较；固定中脊与隐藏紧固耳存在桥接。C倾斜或侧颊着床打印，叶片薄边防翘曲。所有最小壁厚按实际线宽/层厚重新签核。

## 密封和紧固

A-B的6mm搭接负责定位，末端1.5mm泡棉圈按装配1mm建模；两颗M3从下方阴影线沿轴向拉紧。原型须测量压缩后位置、定位间隙、转角连续性和拆装力。0.25mm名义径向间隙不等于实际打印配合。

风扇法兰仅一片泡棉。四角底装M4捕获螺母在安装风扇前预装，由垫片/风扇夹持；需验证螺母旋转、底部剩余壁厚与垫片压紧，无法通长螺栓的风扇改用对应型号紧固方式。不可在未选型号前统一螺钉长度。

C用两颗M3枢轴螺钉和弹性摩擦垫圈保持角度；候选螺母陷槽需防松测试。轴孔存在制造与运动间隙，必须检查侧轴孔泄漏；当前未设计承诺气密的动密封。止挡是轻操作限位，不能承担冲击载荷。

A侧座为4处盲孔，保留空气侧壁。当前Ø5.2×4.2孔只代表嵌件空间，实际热熔嵌件通常需要厂商建议的干涉配合孔，选定货号后改参数并做拉脱试片。盲孔底不可被螺钉顶穿。螺钉长度也需按隔垫1mm、板2mm和有效啮合深度确定。

## 薄板支架

候选2mm钢板、内R2、两次90°折弯。真实圆弧实体保持板厚；展开图以K=0.4估算，未计供应商校准的回弹和折弯扣除，不可直接投料。材料牌号、镀层、防锈、边缘去毛刺和弯折顺序需供应商确认。没有FEM或实物强度合格结论。

安装包络只以4040实心阻挡体检查净空；不代表已模拟真实T槽、T螺母和方向盘角码。支架外端4孔中只用对应的2孔，孔间24/28mm均为候选设计，需核对实际型材槽方向、工具和头部空间。该侧置安装把型材移到风扇外侧；不得转而把横梁放在进气面正下方。

## 实物放行

先打A-B止口、C轴颊和嵌件座试片，验证配合、磨损、保持扭矩和拉脱。装配后封堵入口出口做低压检漏，测量风扇运转温升及振动；根据实测质量重心确定静载和动态载荷。测量同型号风扇、同PWM下的三角度风速/风量与噪声。上述均未完成，不得将CAD通过当作实物合格。
