JKsuper/Wrench-Racing/AERO120_R413_ARCHITECTURE/10_Previews/crossbar_assembly.png

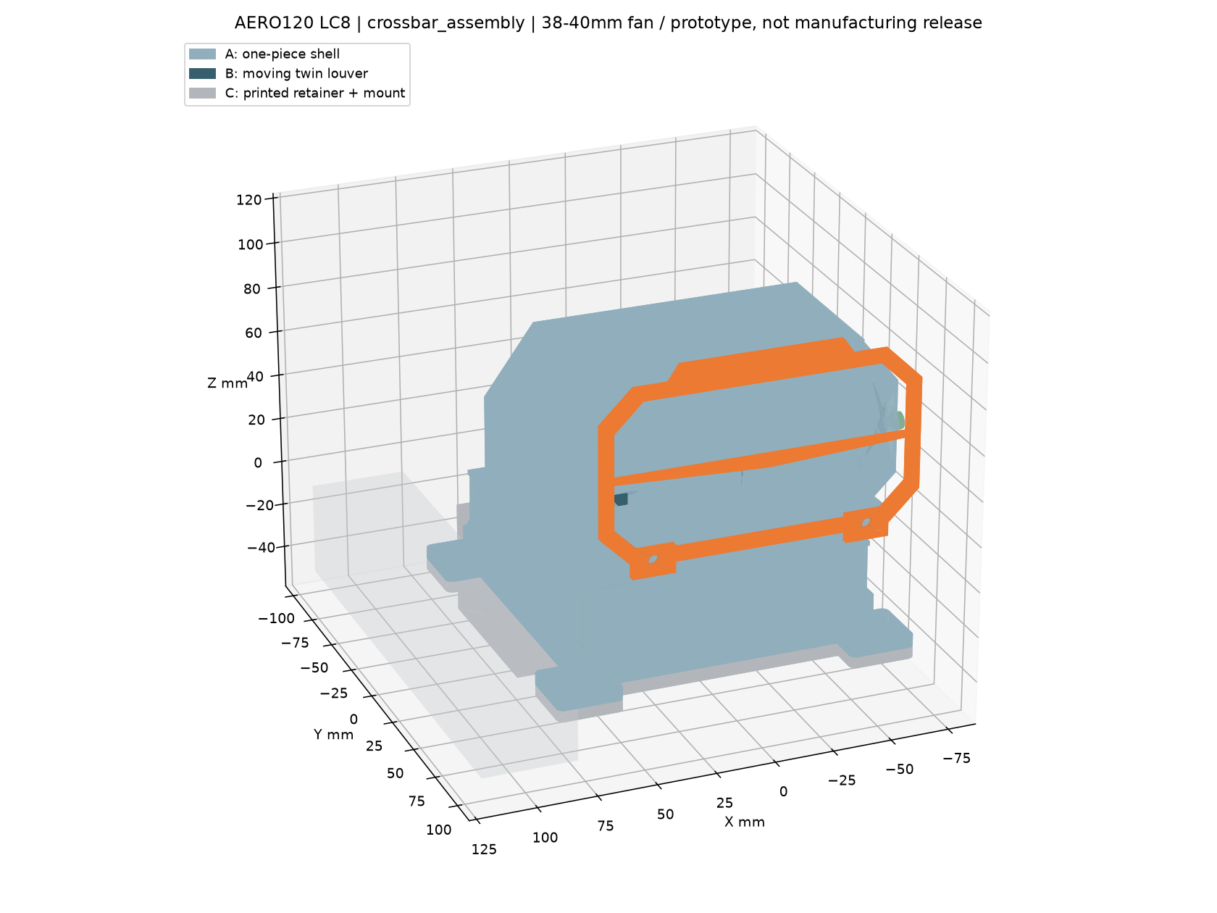
AERO120_R413_ARCHITECTURE/10_Previews/crossbar_assembly.png
