JKsuper/Wrench-Racing/AERO120_R413_ARCHITECTURE/10_Previews/upright_assembly.png

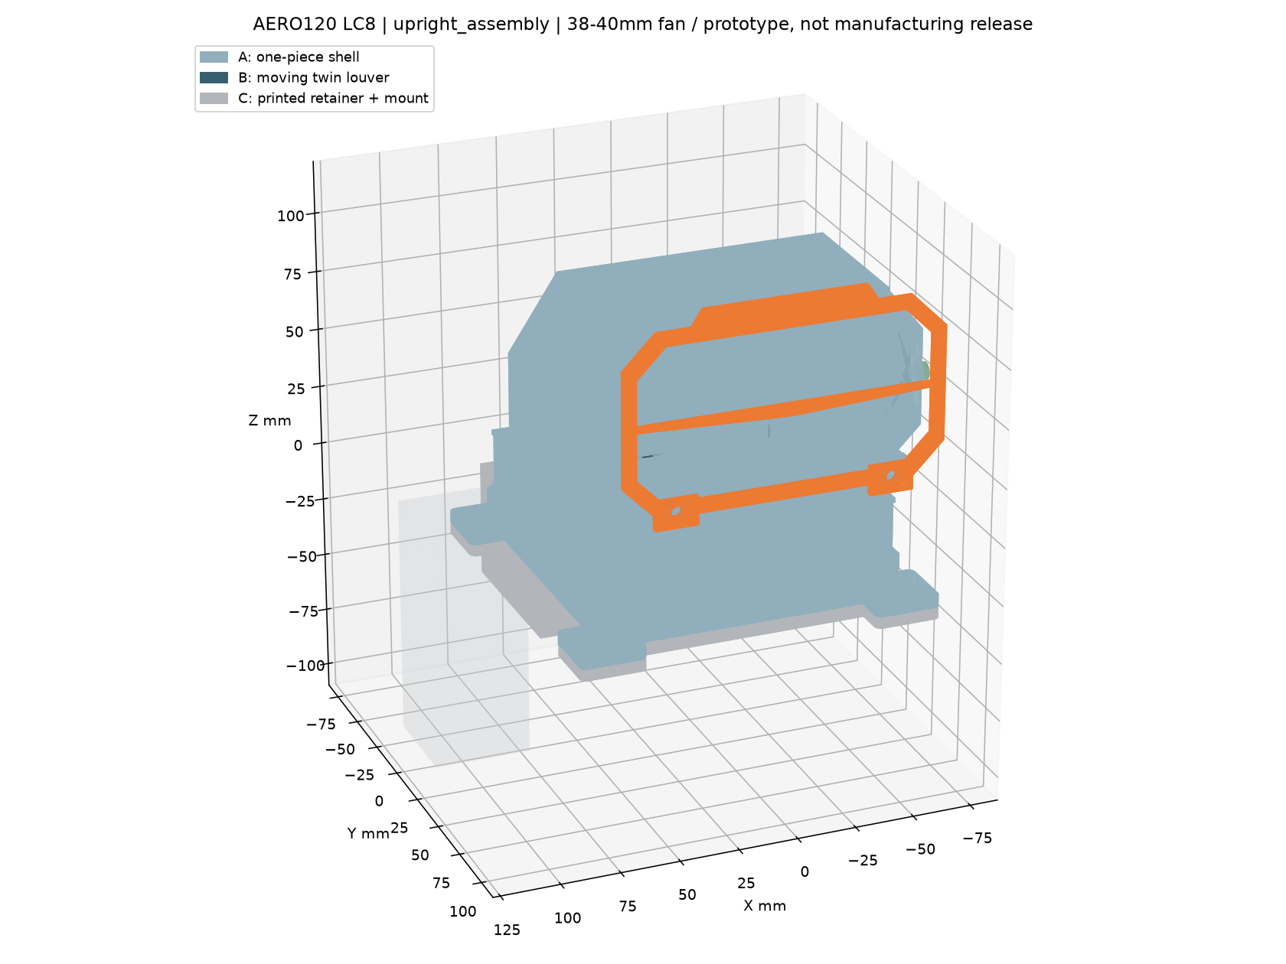
AERO120_R413_ARCHITECTURE/10_Previews/upright_assembly.png
