JKsuper/Wrench-Racing/AERO120_R413_ARCHITECTURE/04_QA/LC1_打样门槛.csv

ID | 检查项 | 本轮状态 | 放行要求
LC01 | 124法兰105孔距及单风扇密封面 | 自动测试 | 按选定风扇实物核对
LC02 | 塑料体积150cm3预算 | 自动测试 | 以切片总价60元预算复核
LC03 | 左右STEP及STL拓扑 | 自动测试 | 有效实体与网格测试通过
LC04 | 百叶±12度和超程实体止挡 | 自动测试 | 0.5度离散无碰撞仍需连续运动及磨损试片
LC05 | 主体封堵后内腔闭合 | 拓扑测试 | 不替代A-B接缝及轴孔实物检漏
LC06 | 隐藏M3螺钉工具通道 | 局部包络检查 | 真实工具和螺钉实装
LC07 | 4040立柱横梁两装配 | 保守实心包络检查 | 补齐实际槽型T螺母及角码占位
LC08 | 25/38/50/55风扇和出线 | 包络检查 | 实际型号护网及出线口复核
LC09 | 1.8mm薄壁和支撑 | 未切片 | 必须记录切片时长支撑重量及去除方案
LC10 | 支架折弯和强度 | 未验证 | K值/材料/回弹/静载振动及嵌件拉脱试验
LC11 | 风量压降噪声 | 未实测 | 与R4.12同条件对照
LC12 | 单侧总价不含风扇100元 | 未报价 | 全部BOM加加工起步费运费分摊不超过目标
