JKsuper/Wrench-Racing/AERO120_R413_ARCHITECTURE/04_QA/LC2_放行门槛.csv

ID | 项目 | 本轮结果 | 打样前要求
01 | 每侧仅两件打印STL | 自动测试通过 | 核对PRINT_SELECTION左右选择
02 | 38至40mm风扇入壳 | 包络通过 | 实测风扇外框厚度出线口及打印收缩
03 | 121.6方内腔43mm轴向余量 | 名义尺寸已留 | 切片与试装确认有效余量
04 | 侧线孔与护线套 | 14×10mm圆角孔/4针插头先穿后装风扇 | 具体线束及护套型号复核/止拉及防磨
05 | ±12度百叶与止挡 | 49个半度采样及超程测试通过 | 连续运动与保持扭矩磨损试验
06 | 主体压力侧闭合 | 封堵后拓扑通过 | 顶部风扇垫及轴孔实物检漏
07 | 外圈夹持和宽托边 | 名义碰撞及滑入路径通过 | 夹紧力/托边蠕变/翻转防脱/振动试验
08 | 封口法兰与支架一体金属件 | 单实体两折弯通过 | 实际板材K值回弹及开口应力集中复核
09 | 4040立柱横梁 | 实心占位包络通过 | 具体槽型角码T螺母及工具空间验证
10 | 集成外壳制造 | 未切片 | 验证内部支撑移除及整体报废风险
11 | 风量压降噪声温升 | 未实测 | 同型号风扇实测
12 | 单侧100元目标 | 未报价 | 完整BOM加工起步及运费分摊核价
