JKsuper/Wrench-Racing/AERO120_R413_ARCHITECTURE/04_QA/LC4_放行门槛.csv

ID | 项目 | 状态 | 放行要求
01 | 三件功能件及可选D装饰罩 | 几何检查通过 | 每侧各一件/左侧需镜像
02 | 四组M4对孔与底盖靠合 | 几何检查通过 | 实装螺钉长度垫圈螺母及允许扭矩
03 | 38至40风扇与公差 | 包络通过 | 实际工艺尺寸和泡棉预压试配
04 | 四针插头通道 | 包络通过 | 实际插头锁扣先穿后装验证
05 | 百叶±12度及止挡 | 采样通过 | 连续运动摩擦保持与磨损
06 | 打印底盖与支架强度 | 未验证 | 静载/振动/温升蠕变/耳根拉脱
07 | 压力侧闭合 | 封堵拓扑通过 | 实物轴孔及风扇泡棉检漏
08 | 4040立柱横梁 | 包络通过 | 具体T槽角码和工具空间
09 | 切片和支撑 | 未运行 | 层向材料壁线数和内部支撑移除
10 | 风量噪声温升 | 未实测 | 同型号同工况测量
11 | 单侧100元目标 | 未报价 | 重新核对三打印件及五金密封总价
