JKsuper/Wrench-Racing/AERO120_R413_ARCHITECTURE/04_QA/LC8_放行门槛.csv

项目 | 已完成 | 未完成
LC7装入干涉 | LC8移动中脊并补装入回归 | 实际装配
四件导出文件 | 独立STL_STEP核验 | 店铺切片
M4_M5_M6型材孔 | 7mm通孔及大垫圈座几何 | 实际T槽和螺栓长度
一体风道支撑 | 识别约110x64内顶面 | 店铺方向支撑及清理确认
薄壁叶片与中脊 | 几何保留1.4及2mm | 真实切片成形
四向安装 | 条件占位通过 | 前侧高立柱及后向线束
性能 | 无实测 | 承载蠕变振动检漏气动
预算 | 100元目标 | 完整报价
