JKsuper/Wrench-Racing/AERO120_R413_ARCHITECTURE/00_Archive/LC3_file_backup_20261029_235846/09_Test_Reports/评审结论.md

# LC3 评审结论

四针KF2510参考图纸为Everconn 2510系列，4P壳宽10.76±0.3mm；具体用户插头型号尚未提供。本轮以12×8×16mm包络验证14×10mm/R1通孔，插头在风扇安装前穿过。侧隙不是插头通道。

线孔移到Z=-24，参考割缝软片22×18×1mm位于抱箍下方，不增加打印件。出口采用斜切宽肩、箭形前伸中脊、上下眉刃和双槽；两打印件合计约150.41cm³（较LC2增加约1.2%）。

16项测试覆盖原14项以及四针包络穿孔路径、两侧枢轴贯通。同步修正正侧枢轴原切孔深度不足，避免只在内侧形成盲孔。压力侧拓扑检查临时封堵入口出口及两轴孔；不代表实物气密。

38–40mm风扇、尺寸压力样本、两安装方式、49处百叶半度行程、实体止挡、滑入托架、单实体、两STL网格及源码报告一致性均检查。材料成本、打印支撑、风扇实物插头/锁扣尺寸、摩擦保持、承载和流量噪声未签核。
