JKsuper/Wrench-Racing/AERO120_R413_ARCHITECTURE/00_Archive/LC5_file_backup_20261030_010514/09_Test_Reports/评审结论.md

# LC5评审结论

用户现有M4×16和普通M4螺母，本版转轴调整为M4孔、Ø12轴座及缩短夹持。按非沉头16mm、两片0.5mm平垫、3.5mm螺母包络，百叶夹持总14mm，底盖总14.5mm。普通螺母的防松和摩擦片阻尼尚未实测。

四针线孔扩大18×14/R2、软片28×24；扩大插头16×12×18压力包络及孔上/下材料检查。底盖孔位四向对称，可旋转换安装边；型材检查以顶面位于风口下方为条件，前侧贯穿高立柱不在合格声明内。

22项测试通过仅表示所述几何条件。未运行切片、未取得100元达标报价、未进行承载/蠕变/振动/密封/气动及插头实物测试。
