JKsuper/Wrench-Racing/AERO120_R413_ARCHITECTURE/00_Archive/LC6_file_backup_20261030_012255/09_Test_Reports/评审结论.md

# LC6评审结论

新增可选的独立换色罩D，顶部Wrench Racing真实浮雕，左右同件、导出不镜像。D约44.34cm³/56g PETG理论净重；A/B/C加强主体约216.07cm³/274g；含罩总约331g，不含支撑与损耗。

A、C四角承压区从窄圆耳改为28x28局部宽板；A增加14mm高局部耳根筋，受力连接到相邻两面壳壁。孔外侧名义余肉6.6mm，保留M4x16的原夹持叠层。此为几何改进，不能宣称提高了多少倍承载。

27项几何测试通过。首次上提检查曾检出外罩下前沿与主体干涉，现已将前部完全开放，0至120mm选定上提位置无硬干涉。品牌实体、四角材料探针、外罩螺栓通道、左右通用、四向安装、百叶、风扇、插头和封堵压力侧都在报告范围内。

没有切片、报价或承载/蠕变/气密/气动/防松实测。装饰罩与加强材料增量需重新报价，100元目标未确认。
