JKsuper/Wrench-Racing/AERO120_R413_ARCHITECTURE/00_Archive/LC4_file_backup_20261030_003325/09_Test_Reports/评审结论.md

# LC4当前状态

用户要求改为打印材料；金属托架、抱箍和隔柱已取消。A外壳、B百叶、C底盖安装支架均为独立打印件。螺钉螺母垫圈等普通五金保留。

底盖4mm、侧壁6mm、两道3mm筋，外围4组M4螺栓闭合，无打印螺纹或螺母槽。三打印件约209.34cm³；LC3的150.41cm³未包含当时的金属支架，不应将差值直接换算成售价。

17项几何检查通过，新增四组螺栓穿孔对齐。装配路径改为底盖竖向靠合，不再滑入金属槽；38–40mm、插头穿孔、枢轴贯通、百叶限位、两安装包络、单实体及网格有效性均检查。

没有材料强度、层间承载、蠕变、振动、温升、真实密封或气动性能验证。未切片、未报价，单侧100元未确认；只供工程评审，不得直接量产放行。
