JKsuper/Wrench-Racing/AERO120_R413_ARCHITECTURE/00_Archive/LC7_file_backup_20261030_020216/09_Test_Reports/评审结论.md

# LC7评审

纠正装饰件位置：D改为出风口前框，Wrench Racing移到正面上方；主风道不拆开。A/C四角加强保留。D约8.29cm³，PETG理论净重约10.5g；A/B/C/D总约286g，非实际切片重量。

28项几何检查通过。新增前框与原出口空气截面无重叠，拆卸方向为+Y；百叶±12度、M4参考五金、插头通道、四向底盖、宽四角、网格及压力侧闭合均回归。

前饰盖通过两套独立M4×16固定，不借用转轴；名义夹持14mm，具体螺钉头型/后侧工具操作尚未实装签核。没有承载、蠕变、气密、气动或100元达标结论。
