JKsuper/Wrench-Racing/AERO120_R413_ARCHITECTURE/00_Archive/LC1_before_LC2_20261029_231237/09_Test_Reports/评审结论.md

# LC1本轮评审结果

2026-10-29。按用户单侧≤100元、不含风扇要求重构。

3个塑料主件实体体积合计142.91cm³；此前作废重建版277.64cm³，减少48.53%。主风道115.78cm³、前罩20.95cm³左右、共轴内芯6.18cm³。准确分项以geometry.json和08_BOM/材料量比较.csv为准。材料量比较排除了支撑、废料、垫片、金属和紧固件；绝不按48.53%推断降价比例。

14项自动测试通过：源码哈希与报告匹配、单实体有效性、左右网格边关联/有向体积、装配零件对碰撞、49个半度运动位置、两向超程止挡、四种风扇厚度与示例出线包络、两种4040阻挡包络、前罩工具路径、材料预算、孔中心、盲孔壁和密封面抽查、主体封堵内腔拓扑。

主体闭合测试在CAD中封堵入口/出口/风扇螺钉孔；结果为1实体2壳层，保留封闭内部空气腔。此方法没有验证A-B实际接缝、侧轴孔动态密封、打印孔隙或整机气密性。

零件包含真实搭接、捕获螺母槽、转轴孔和机械止挡；装配STEP的螺钉、螺纹嵌件、T螺母和护网尚未按采购型号建模，风扇与4040仅为标明的包络。因此碰撞报告也不代表完整紧固件工具空间签核。

未运行切片，未取得报价，未进行承载/振动/气流噪声/泄漏实测。当前状态：CAD几何候选完成；100元目标尚未验证；禁止作为量产放行文件。
