JKsuper/Wrench-Racing/AERO120_R413_ARCHITECTURE/00_Archive/LC6_file_backup_20261030_012255/04_QA/LC6_新增检查.csv

项目 | 几何检查 | 实物状态
四角宽承压与耳根筋 | 已建模且材料探针通过 | 承载与蠕变未验证
外罩升起拆装 | 选定路径无碰撞 | 打印公差与顶部空间待试装
品牌实体与左右通用 | 导出不镜像D且凸字有效 | 打印字迹待确认
独立两M4固定外罩 | 通道无干涉 | 防松和振动待试装
换色材料与费用 | 新增D独立STL | 批次差异和报价待确认
