JKsuper/Wrench-Racing/AERO120_R413_ARCHITECTURE/00_Archive/LC7_file_backup_20261030_020216/04_QA/LC7_放行门槛.csv

项目 | 几何结果 | 未完成验证
一体主风道 | 单实体及压力侧闭合 | 实际检漏
前饰盖位置与品牌 | 仅出风口前圈/正面品牌 | 字迹与配色打样
前盖拆装及M4通道 | 名义路径通过 | 螺钉头型与实际工具空间
原出口和百叶 | 截面与±12度采样无干涉 | 风量噪声
四角及四向安装 | 宽根与占位保持 | 承载蠕变及座舱实装
成本与切片 | 未报价未切片 | 含工时五金支撑整套核价
