JKsuper/Wrench-Racing/(commit log)

2026-10-29 Import AERO120 R4.13 LC8 engineering baseline and handoff
    [01_A_integrated_shell.stl, 02_B_twin_louver.stl, 03_C_printed_base_mount.stl, 04_D_Wrench_Racing_colour_shell.stl, 04_D_Wrench_Racing_front_bezel.stl, 06_尺寸与理论用料.csv, A_duct_fit_coupon_1.step, A_duct_fit_coupon_1.stl]
2026-10-29 Preserve CAD checksums and document cloud handoff
    [06_尺寸与理论用料.csv, BOM_单侧.csv, C_metal_cap_mount_FLAT_UNQUALIFIED.dxf, D_common_bracket_FLAT_K04_UNQUALIFIED.dxf, LC2_放行门槛.csv, LC4_放行门槛.csv, LC6_新增检查.csv, LC7_放行门槛.csv]
